QuantumQuadrate/ShutterDriverV2.0/design_pdfs/PCB_3D.png

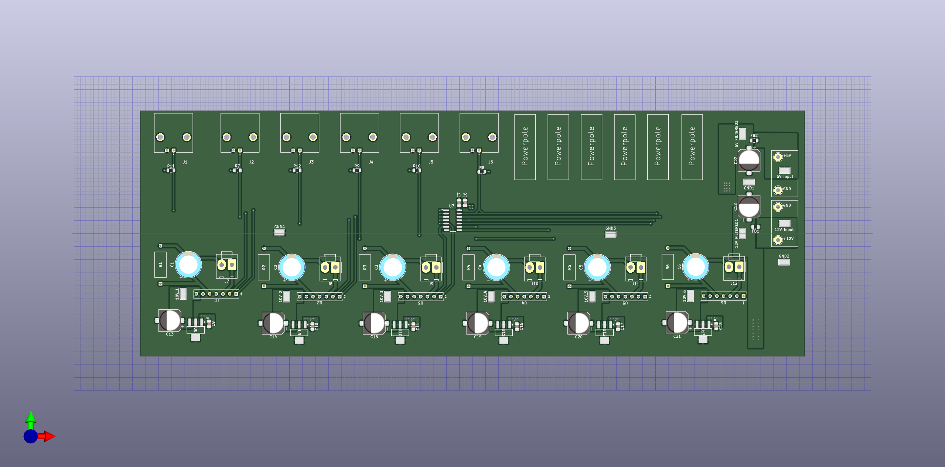
design_pdfs/PCB_3D.png
