QuantumQuadrate/ShutterDriverV2.0/atom.png

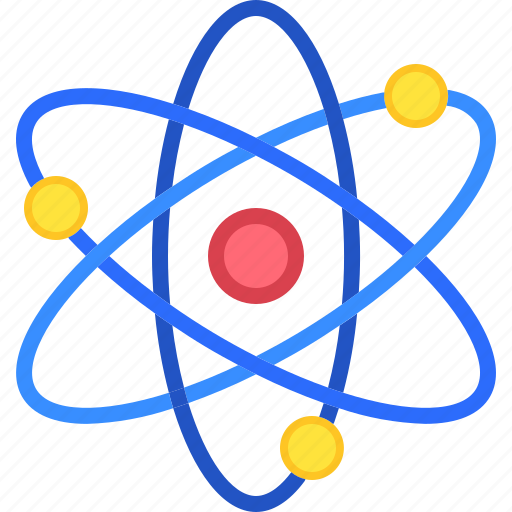
atom.png
