QuantumQuadrate/ShutterDriverV2.0/parts_list.xlsx

Part | Quantity | Link
330uF Capacitor | 8 | https://www.digikey.com/en/products/detail/panasonic-electronic-components/EEE-FN1E331P/11657037
0.01uF Capacitor (Bypass) | 1 | https://www.digikey.com/en/products/detail/samsung-electro-mechanics/CL21B103KCANNNC/3886907
0.1uF Capacitor (Bypass) | 1 | https://www.digikey.com/en/products/detail/samsung-electro-mechanics/CL21B104KCFNNNE/5961324
220 Ohm Resistor (Motor) | 6 | https://www.digikey.com/en/products/detail/yageo/FMP200FRF52-220R/2058633
BNC Connector | 6 | https://www.digikey.com/en/products/detail/te-connectivity-linx/CONBNC002/16013841
H-Bridge | 6 | https://www.digikey.com/en/products/detail/toshiba-semiconductor-and-storage/TB6568KQ-8/3671309
Inverter | 1 | https://www.digikey.com/en/products/detail/texas-instruments/SN74LS06DR/562907
220uF Capacitor (Motor) | 6 | https://www.digikey.com/en/products/detail/panasonic-electronic-components/ECE-A1EN221U/227622
0.47uF Capacitor | 6 | https://www.digikey.com/en/products/detail/samsung-electro-mechanics/CL21B474KBFNNNG/3894539
Regulator | 6 | https://www.digikey.com/en/products/detail/texas-instruments/LM2940IMP-10-NOPB/363886
Test Point | 16 | https://www.digikey.com/en/products/detail/keystone-electronics/5019/3907343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
1A Ferrite Bead | 1 | https://www.digikey.com/en/products/detail/fair-rite-products-corp/2508051027Y1/8594251
6A Ferrite Bead | 1 | https://www.digikey.com/en/products/detail/fair-rite-products-corp/2508051217Y6/8594305
1K Pull Up Resistors | 6 | https://www.digikey.com/en/products/detail/yageo/RC0805FR-7W1KL/12698830
