QuantumQuadrate/ShutterDriverV2.0/ShutterDriver/symbols_footprints/SN74LS06DR/SN74LS06DR.step

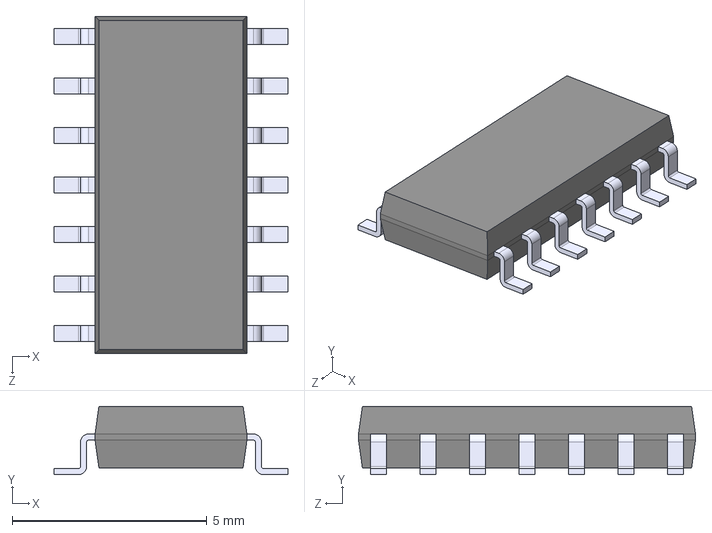
[picture p3: CAD file, 2023-12-11]
ShutterDriver/symbols_footprints/SN74LS06DR/SN74LS06DR.step
6.00 x 1.75 x 8.65 mm
