QuantumQuadrate/ShutterDriverV2.0/design_pdfs/pcb_2d.pdf

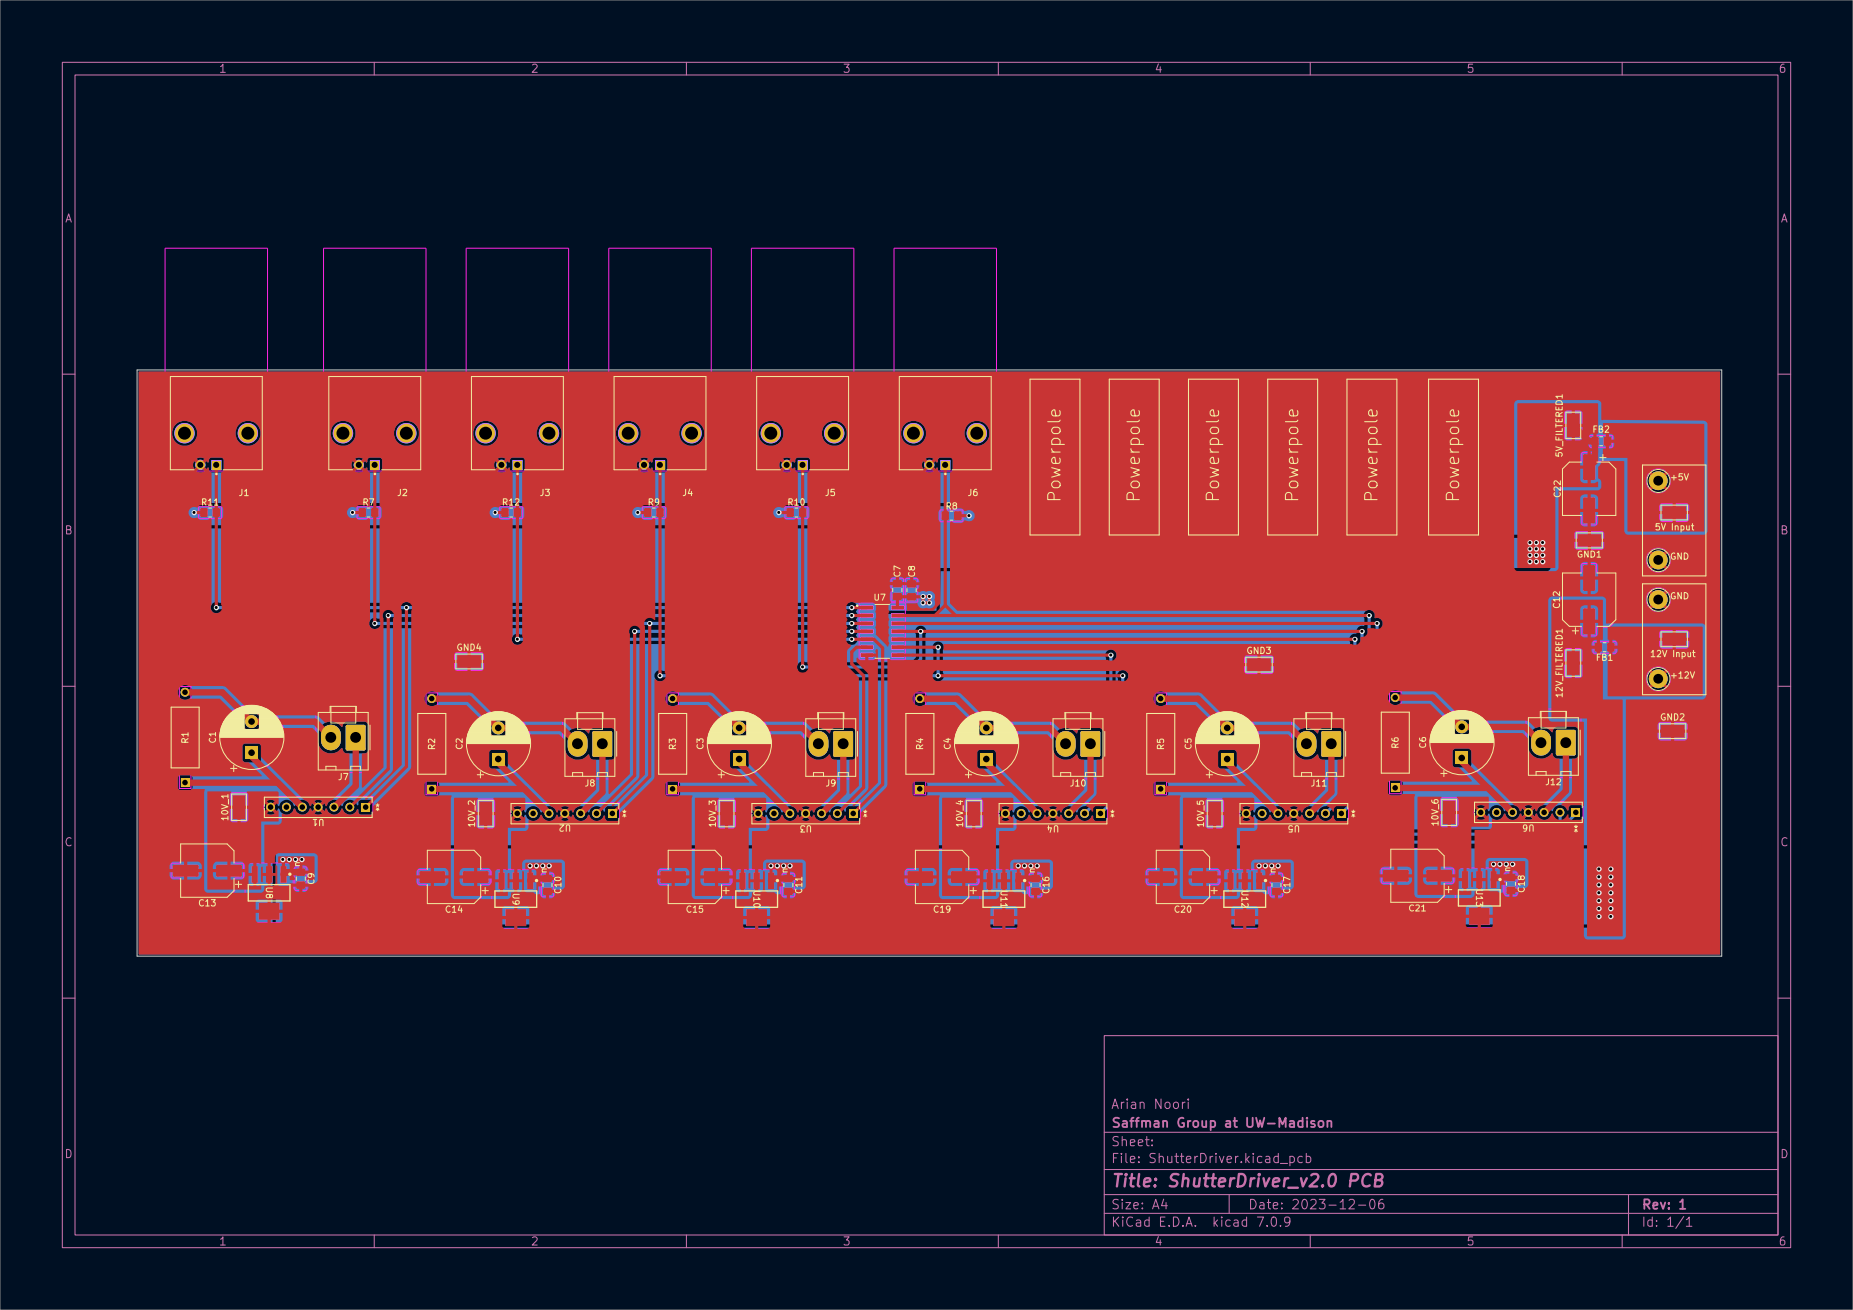
[picture p4: page 1]
