QuantumQuadrate/ShutterDriverV2.0/design_pdfs/schematic.pdf

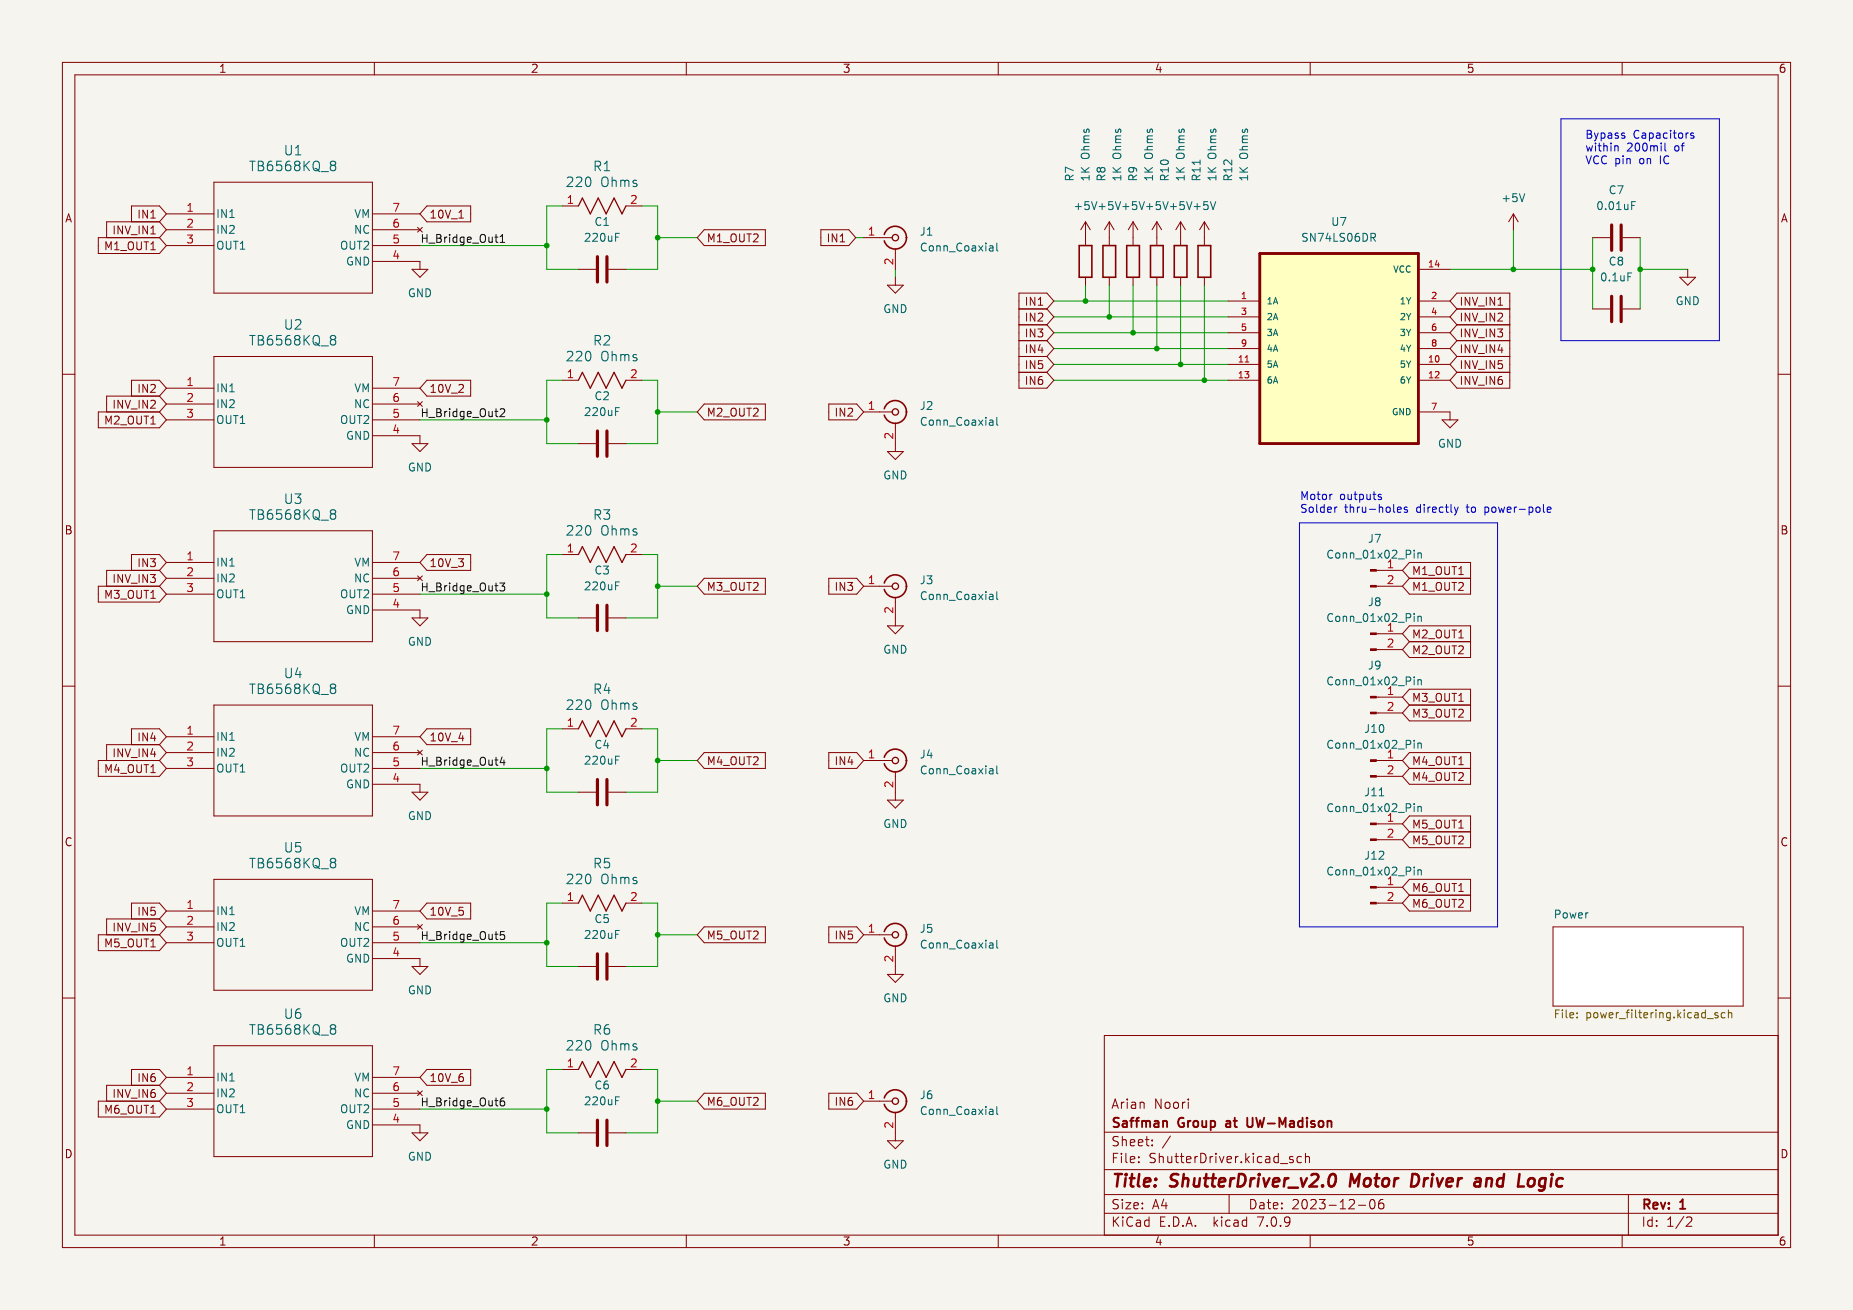
[picture p5: page 1]

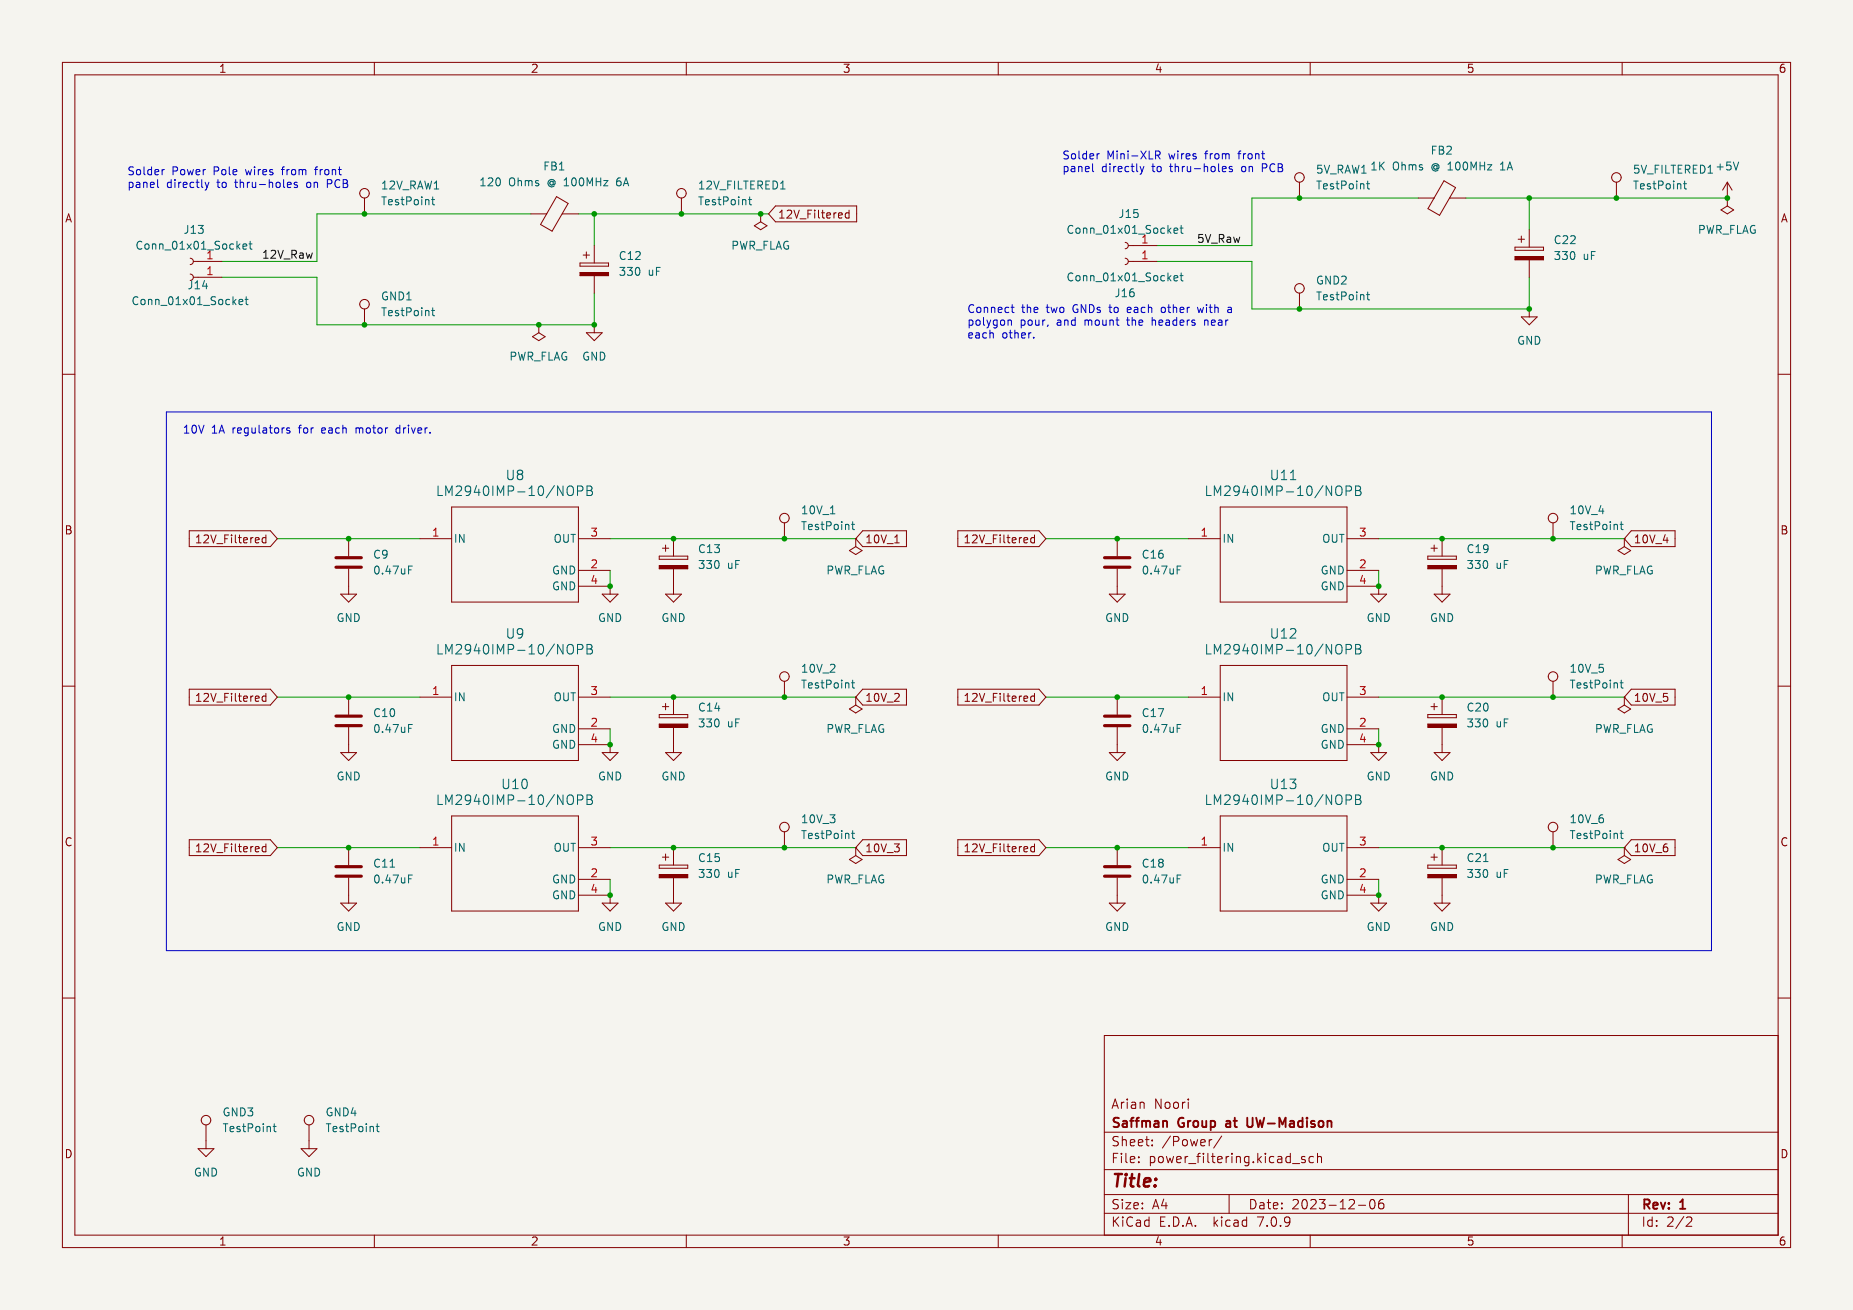
[picture p6: page 2]
