QuantumQuadrate/ShutterDriverV2.0/ShutterDriver/ShutterDriver.kicad_pcb

## KiCad design ShutterDriver/ShutterDriver.kicad_pcb (2023-12-11)

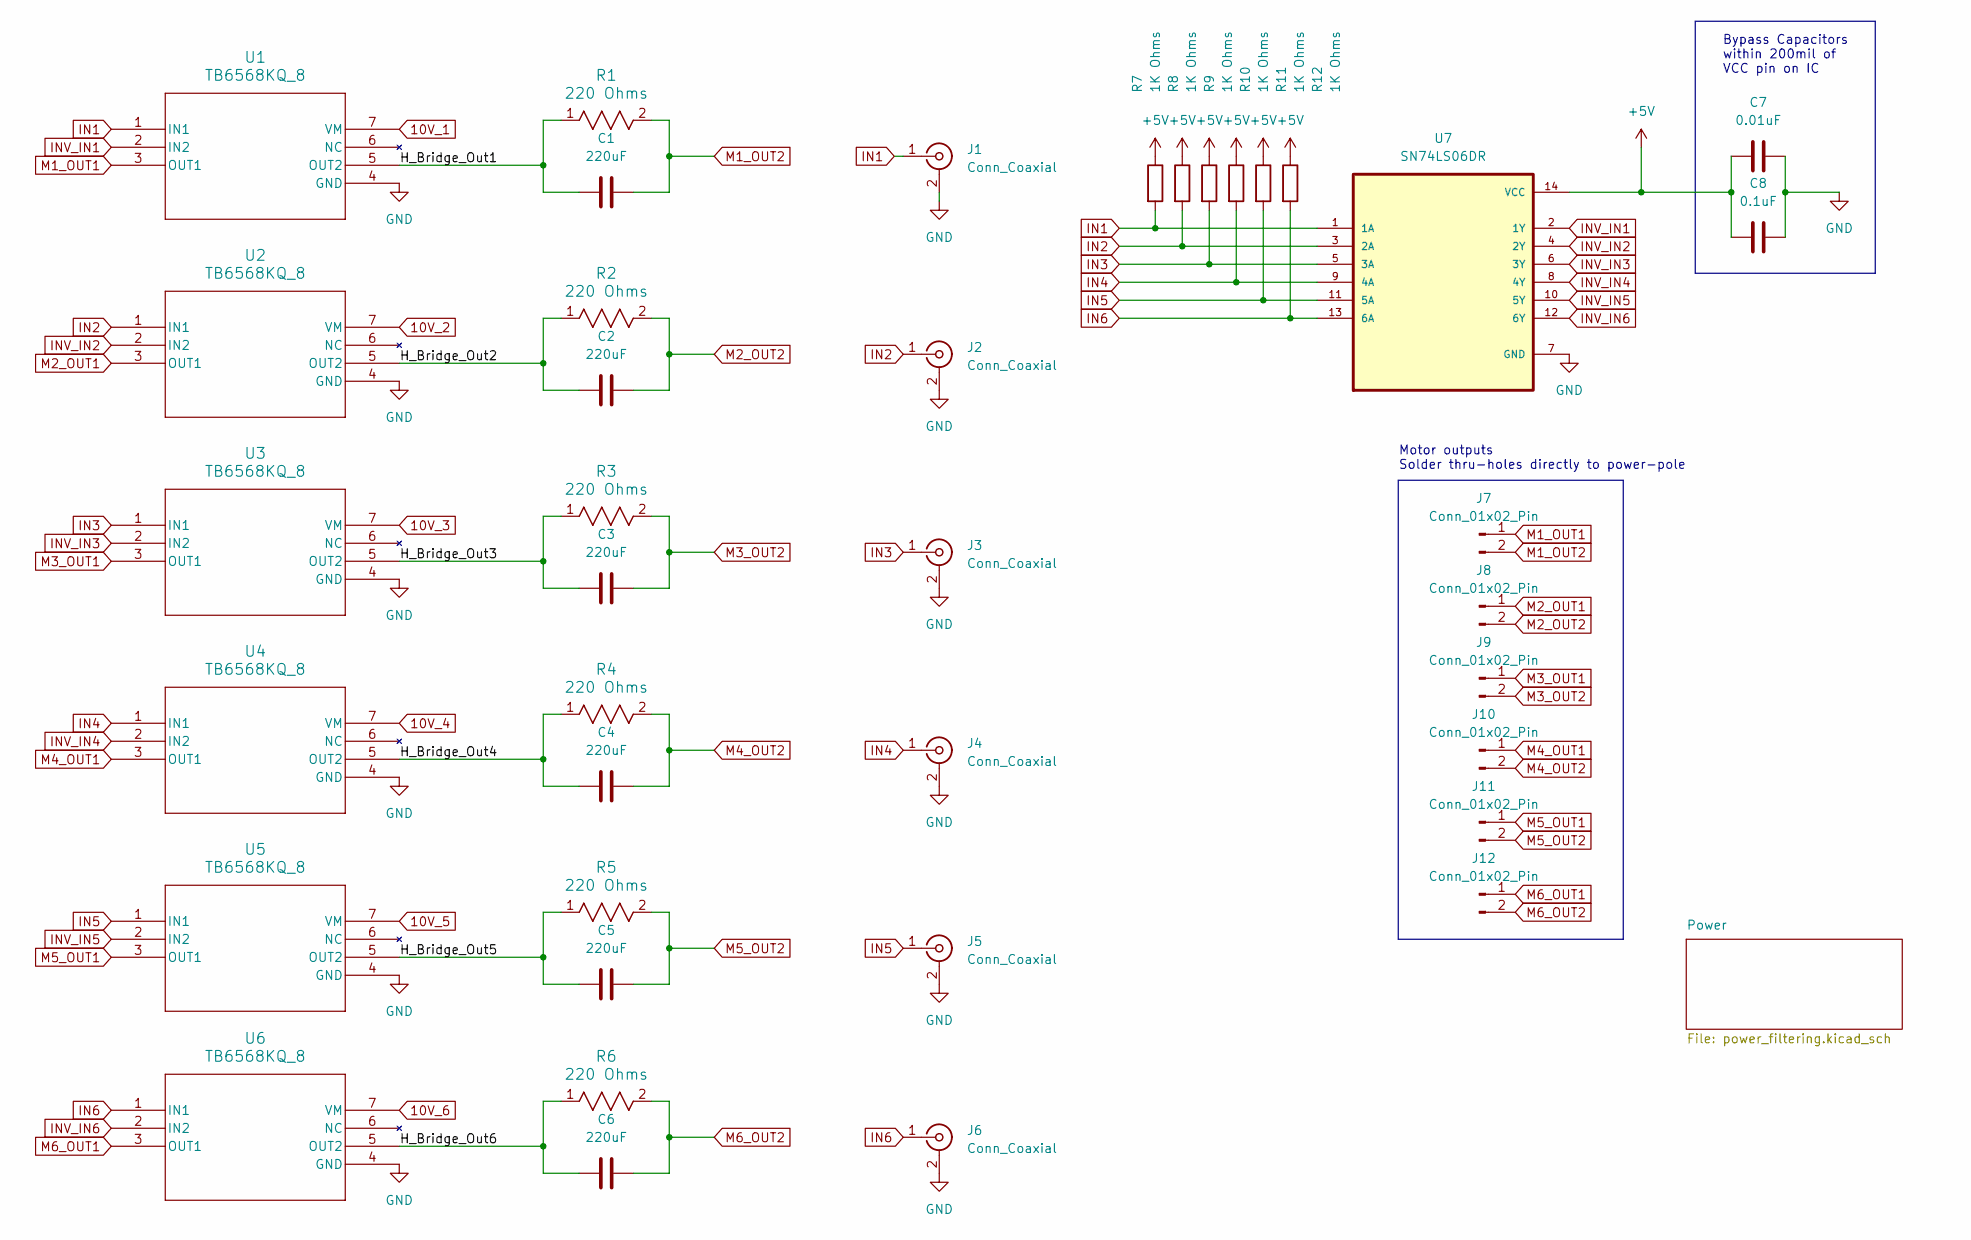
[picture p7: schematic ShutterDriver.kicad_sch, ShutterDriver_v2.0 Motor Driver and Logic]

Parts:
C1, C2, C3, C4, C5, C6: 220uF; CP_Radial_D10.0mm_P5.00mm; Part Number ECE-A1EN221U
C7: 0.01uF; C_0805_2012Metric_Pad1.18x1.45mm_HandSolder; Part Number CL21B103KCANNNC
C8: 0.1uF; C_0805_2012Metric_Pad1.18x1.45mm_HandSolder; Part Number CL21B104KCFNNNE
J1, J2, J3, J4, J5, J6: Conn_Coaxial; LINX_CONBNC002; Part Number CONBNC002
J7, J8, J9, J10, J11, J12: Conn_01x02_Pin; Molex_KK-396_A-41791-0002_1x02_P3.96mm_Vertical
R1, R2, R3, R4, R5, R6: 220 Ohms; YAG_FMP200_YAG
R7, R8, R9, R10, R11, R12: 1K Ohms; R_0805_2012Metric_Pad1.20x1.40mm_HandSolder
U1, U2, U3, U4, U5, U6: TB6568KQ_8; HSIP7-P-2p54A_TOS
U7: SN74LS06DR; SOIC127P600X175-14N

Connections:
10V_1: U1.7 (VM); also elsewhere on the board
10V_2: U2.7 (VM); also elsewhere on the board
10V_3: U3.7 (VM); also elsewhere on the board
10V_4: U4.7 (VM); also elsewhere on the board
10V_5: U5.7 (VM); also elsewhere on the board
10V_6: U6.7 (VM); also elsewhere on the board
+5V: C7.1, C8.1, R7.1, R8.1, R9.1, R10.1, R11.1, R12.1, U7.14 (VCC); also elsewhere on the board
/H_Bridge_Out1: C1.1, R1.1, U1.5 (OUT2)
/H_Bridge_Out2: C2.1, R2.1, U2.5 (OUT2)
/H_Bridge_Out3: C3.1, R3.1, U3.5 (OUT2)
/H_Bridge_Out4: C4.1, R4.1, U4.5 (OUT2)
/H_Bridge_Out5: C5.1, R5.1, U5.5 (OUT2)
/H_Bridge_Out6: C6.1, R6.1, U6.5 (OUT2)
GND: C7.2, C8.2, J1.2 (Ext), J2.2 (Ext), J3.2 (Ext), J4.2 (Ext), J5.2 (Ext), J6.2 (Ext), U1.4 (GND), U2.4 (GND), U3.4 (GND), U4.4 (GND), U5.4 (GND), U6.4 (GND), U7.7 (GND); also elsewhere on the board
IN1: J1.1 (In), R11.2, U1.1 (IN1), U7.1 (1A)
IN2: J2.1 (In), R7.2, U2.1 (IN1), U7.3 (2A)
IN3: J3.1 (In), R12.2, U3.1 (IN1), U7.5 (3A)
IN4: J4.1 (In), R9.2, U4.1 (IN1), U7.9 (4A)
IN5: J5.1 (In), R10.2, U5.1 (IN1), U7.11 (5A)
IN6: J6.1 (In), R8.2, U6.1 (IN1), U7.13 (6A)
INV_IN1: U1.2 (IN2), U7.2 (1Y)
INV_IN2: U2.2 (IN2), U7.4 (2Y)
INV_IN3: U3.2 (IN2), U7.6 (3Y)
INV_IN4: U4.2 (IN2), U7.8 (4Y)
INV_IN5: U5.2 (IN2), U7.10 (5Y)
INV_IN6: U6.2 (IN2), U7.12 (6Y)
M1_OUT1: J7.1, U1.3 (OUT1)
M1_OUT2: C1.2, J7.2, R1.2
M2_OUT1: J8.1, U2.3 (OUT1)
M2_OUT2: C2.2, J8.2, R2.2
M3_OUT1: J9.1, U3.3 (OUT1)
M3_OUT2: C3.2, J9.2, R3.2
M4_OUT1: J10.1, U4.3 (OUT1)
M4_OUT2: C4.2, J10.2, R4.2
M5_OUT1: J11.1, U5.3 (OUT1)
M5_OUT2: C5.2, J11.2, R5.2
M6_OUT1: J12.1, U6.3 (OUT1)
M6_OUT2: C6.2, J12.2, R6.2

Notes on the sheet:
Bypass Capacitors within 200mil of VCC pin on IC
Motor outputs Solder thru-holes directly to power-pole

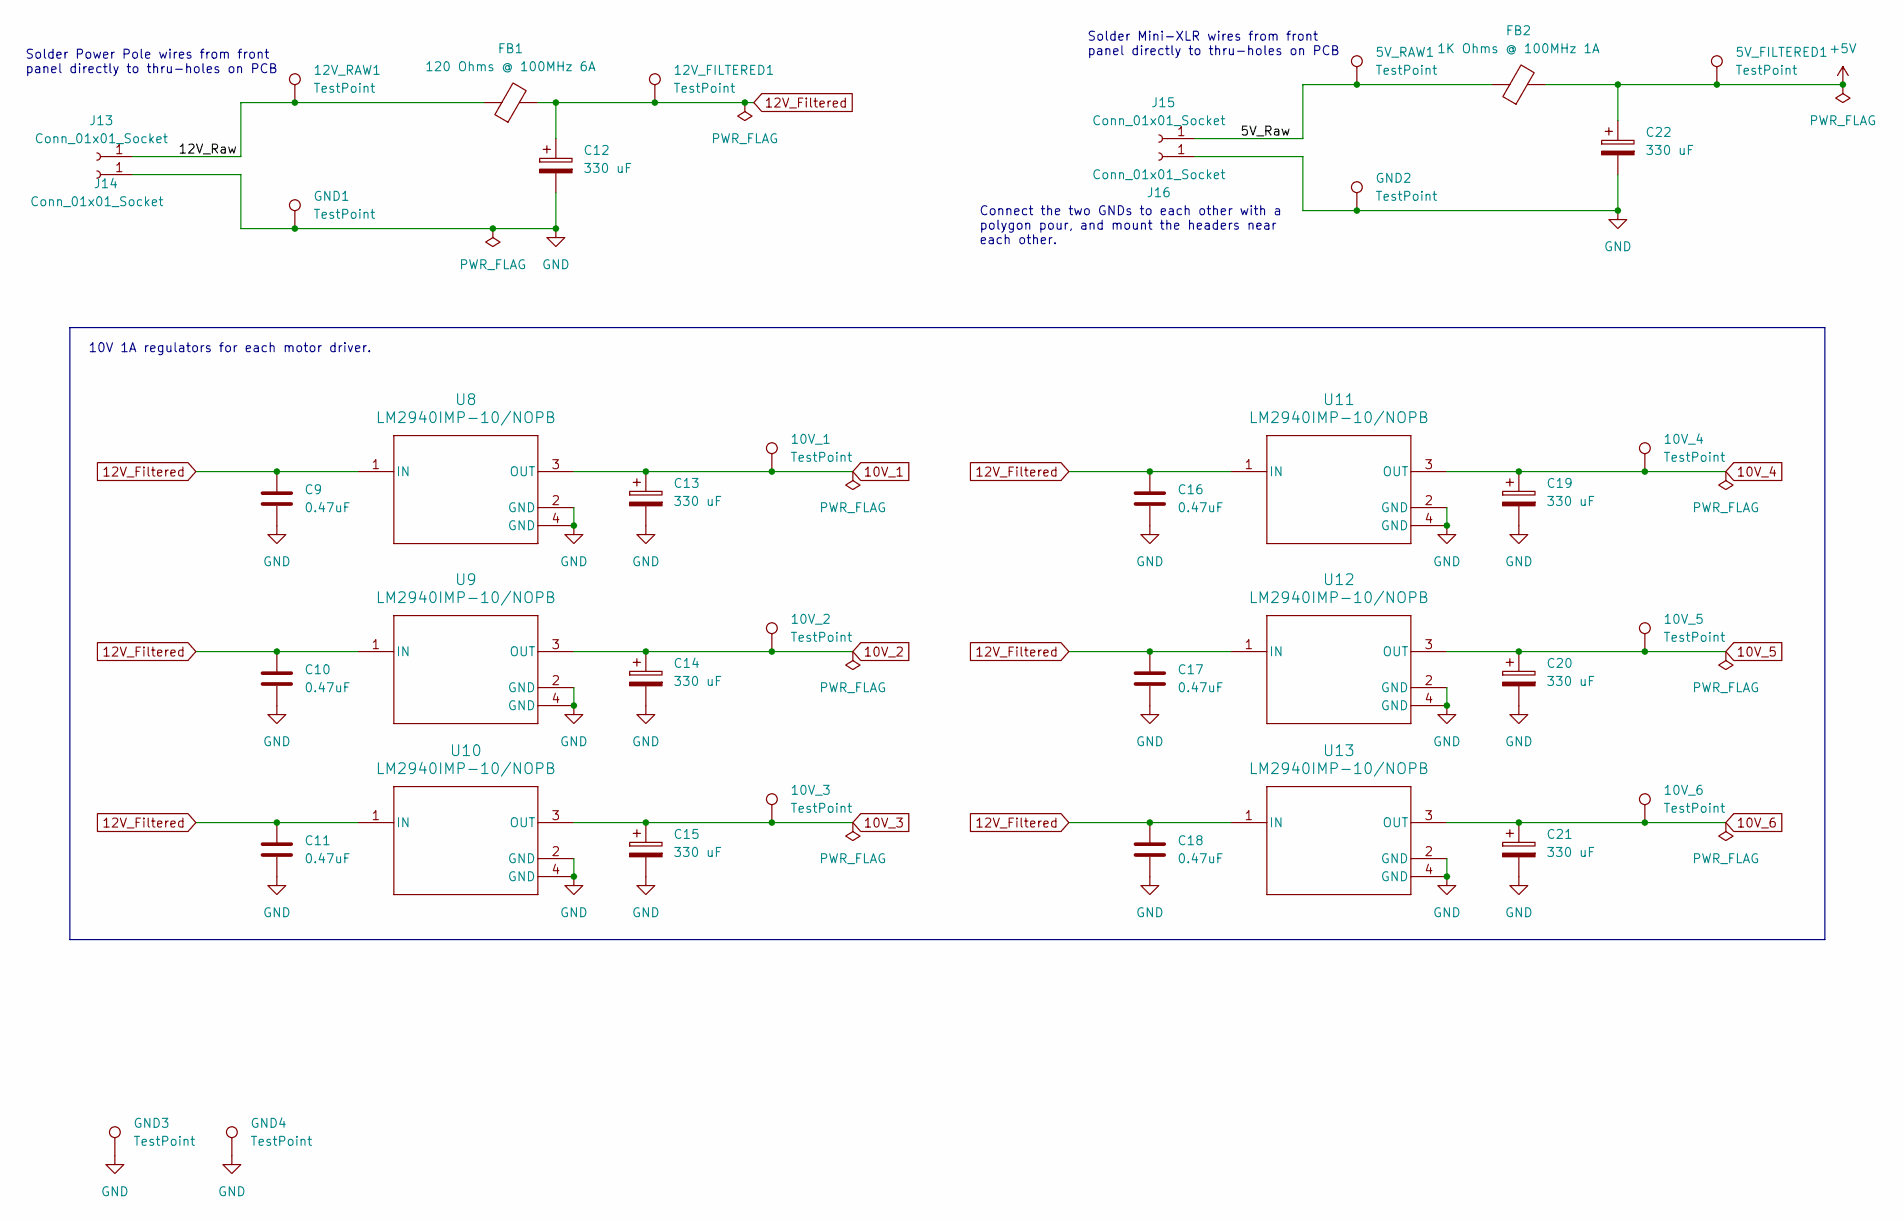
[picture p8: schematic power_filtering.kicad_sch]

Parts:
5V_FILTERED1, 5V_RAW1, 10V_1, 10V_2, 10V_3, 10V_4, 10V_5, 10V_6, 12V_FILTERED1, 12V_RAW1: TestPoint; TestPoint_Keystone_5019_Minature
C9, C10, C11, C16, C17, C18: 0.47uF; C_0805_2012Metric_Pad1.18x1.45mm_HandSolder
C12, C13, C14, C15, C19, C20, C21, C22: 330 uF; CP_Elec_8x11.9
FB1: 120 Ohms @ 100MHz 6A; R_0805_2012Metric_Pad1.20x1.40mm_HandSolder
FB2: 1K Ohms @ 100MHz 1A; R_0805_2012Metric_Pad1.20x1.40mm_HandSolder
GND1, GND2, GND3, GND4: TestPoint; TestPoint_Keystone_5019_Minature
J13, J14, J15, J16: Conn_01x01_Socket; Pin_D1.3mm_L11.0mm_LooseFit
U8, U9, U10, U11, U12, U13: LM2940IMP-10/NOPB; DCY0004A_M

Connections:
10V_1: 10V_1.1, C13.1, U8.3 (OUT); also elsewhere on the board
10V_2: 10V_2.1, C14.1, U9.3 (OUT); also elsewhere on the board
10V_3: 10V_3.1, C15.1, U10.3 (OUT); also elsewhere on the board
10V_4: 10V_4.1, C19.1, U11.3 (OUT); also elsewhere on the board
10V_5: 10V_5.1, C20.1, U12.3 (OUT); also elsewhere on the board
10V_6: 10V_6.1, C21.1, U13.3 (OUT); also elsewhere on the board
12V_Filtered: 12V_FILTERED1.1, C9.1, C10.1, C11.1, C12.1, C16.1, C17.1, C18.1, FB1.2, U8.1 (IN), U9.1 (IN), U10.1 (IN), U11.1 (IN), U12.1 (IN), U13.1 (IN)
+5V: 5V_FILTERED1.1, C22.1, FB2.2; also elsewhere on the board
/Power/5V_Raw: 5V_RAW1.1, FB2.1, J15.1
/Power/12V_Raw: 12V_RAW1.1, FB1.1, J13.1
GND: C9.2, C10.2, C11.2, C12.2, C13.2, C14.2, C15.2, C16.2, C17.2, C18.2, C19.2, C20.2, C21.2, C22.2, GND1.1, GND2.1, GND3.1, GND4.1, J14.1, J16.1, U8.2 (GND), U8.4 (GND), U9.2 (GND), U9.4 (GND), U10.2 (GND), U10.4 (GND), U11.2 (GND), U11.4 (GND), U12.2 (GND), U12.4 (GND), U13.2 (GND), U13.4 (GND); also elsewhere on the board

Notes on the sheet:
Solder Mini-XLR wires from front panel directly to thru-holes on PCB
Connect the two GNDs to each other with a polygon pour, and mount the headers near each other.
Solder Power Pole wires from front panel directly to thru-holes on PCB
10V 1A regulators for each motor driver.

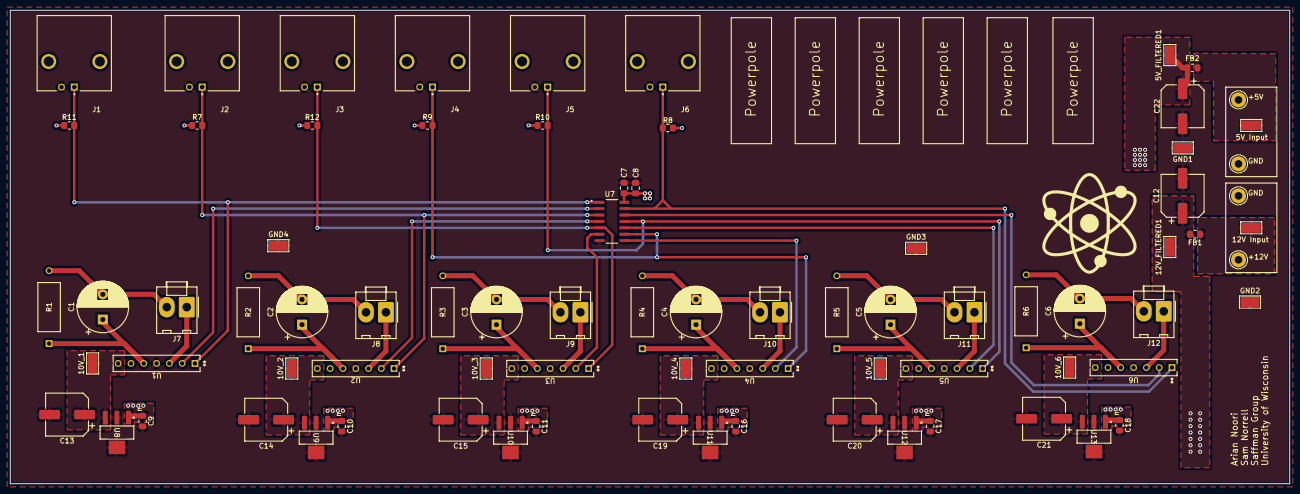
[picture p9: board ShutterDriver.kicad_pcb from above]

Board: 2 copper layers, 254.0 x 94.0 mm, 79 parts (0 on the bottom side), 41 nets.
